JuanSegura98/LinearRegulator/doc/march-25.pptx

## Hito 1 Regulador Lineal

Diseño Avanzado de Sistemas Electrónicos


## Tabla de contenidos 01 03 04 02


Diagrama

Diseño

Diagrama de bloques del sistema

Diseño y validación por simulación de cada bloque

Resultados

BOM

Resultados experimentales

Lista de componentes y estado de adquisición

## Diagrama de bloques

Protección de sobrecorriente

Salida de voltaje

Regulador lineal

Lectura de corriente

Señal de referencia

FPGA

Señal de referencia

Lectura de tensión

Filtro paso-bajo

ICON] Square wave · Issue #165 · iconoir-icons/iconoir · GitHub

## Diseño – Global


## Diseño – Regulador


## Parámetros – Regulador

Parámetro | Valor | Justificación
R1 | 4k | Resistencia de protección Zener. Calculada para izmax = 3.5mA
R2 | 14k | Divisor de tensión resistivo. Calculado para multiplicar la señal de referencia x2.4 (2V -> 4.8V; 3.3V -> 7.94V)
R3 | 10k
Rload | 500 | Resistencia de prueba. Pruebas realizadas con rango de 100 a 1k
Vcc | 14 | Tensión del generador frente a tierra

## Simulación – Regulador


Notes: Barrido de Vout para distintas Vref

## Diseño – Protección de sobrecorriente


## Parámetros – Protección de sobrecorriente

Parámetro | Valor | Justificación
R4 | 6.2 | Calculada para i_rload_max = 150mA

## Simulación – Protección de sobrecorriente


Notes: Barrido de i_rload para distintas Rload

## Diseño – Lectura de corriente


## Parámetros – Lectura de corriente

Parámetro | Valor | Justificación
R6 | 3k | Amplificador de instrumentación ajustado para una ganancia de 4.5 (salida de 3.3V para 150mA de corriente con la resistencia de 6.2)
R7 | 5k
R8 | 5k
R9 | 5k
R10 | 5k
R11 | 5k
R12 | 5k

## Simulación – Lectura de corriente


Notes: Barrido de Vout para distintas Vref

## Diseño – Lectura de tensión


## Parámetros – Lectura de tensión

Parámetro | Valor | Justificación
| | Se usa seguidor de tensión porque la tensión a leer está en el rango 0-3.3V

## Simulación – Lectura de tensión


Notes: Barrido de Vout para distintas Vref

## Diseño – Filtro paso-bajo


## Parámetros – Filtro paso-bajo

Parámetro | Valor | Justificación
R13 | 1k | Filtro de 2º orden (por conexión de dos 1º orden) con frecuencia de corte de 160Hz
R14 | 1k
C1 | 1μ
C2 | 1μ

## Simulación – Filtro paso-bajo


Notes: Barrido de Vout para distintas Vref

## Simulación – Filtro paso-bajo

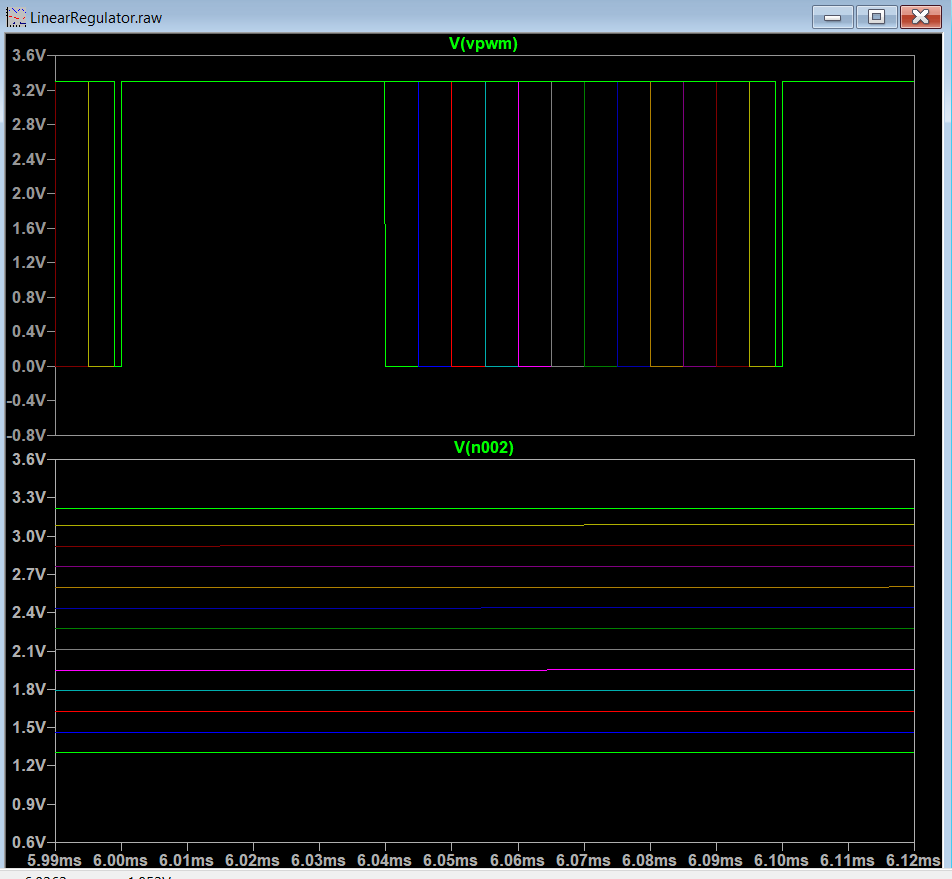
[picture p25: figure]

Notes: Barrido de Vout para distintas Vref

## Diseño – Global

## Simulación – Global


Notes: Barrido de Vout para distintas Vref

## BOM

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

## Estado del pedido

Componente | Cantidad | Precio unidad | Precio total | Estado | Notas
Resistencias | | | 0 | OK
Condensadores | | | 0 | OK
Protoboard | | | 0 | OK
Conectores Dupont | | | 0 | OK
BD135 | 2 | 0.665 | 1.33 | En carrito
BC547B | 2 | 0.361 | 0.722 | En carrito
LM741 | 10 | 0.76 | 7.6 | En carrito
OP07 | 6 | ----- | ----- | SIN EXISTENCIAS* | *Se sustituye por 6 LM741
Disipador TO126 | 1 | 5.64 | 5.64 | En carrito
TOTAL | | | 15.292
