JuanSegura98/LinearRegulator/doc/block-diagram.pptx

Overcurrent protection

Output

Current reader

Linear regulator

FPGA

Voltage reader

PWM
reference signal

DC
reference signal

Low-pass filter
