JuanSegura98/LinearRegulator/doc/BOM.xlsx

Sheet: BOM LTSpice
--- Bill of Materials ---
Ref. | Mfg. | Part No. | Description
C1 | -- | -- | capacitor, 1µF
C2 | -- | -- | capacitor, 1µF
Q1 | -- | BD135 | bipolar transistor
Q2 | NXP | BC547B | bipolar transistor
R1 | -- | -- | resistor, 4K
R2 | -- | -- | resistor, 14K
R3 | -- | -- | resistor, 10K
R4 | -- | -- | resistor, 6.2
R5 | -- | -- | resistor, 0
R6 | -- | -- | resistor, 3K
R7 | -- | -- | resistor, 5K
R8 | -- | -- | resistor, 5K
R9 | -- | -- | resistor, 5K
R10 | -- | -- | resistor, 5K
R11 | -- | -- | resistor, 5K
R12 | -- | -- | resistor, 5K
R13 | -- | -- | resistor, 1K
R14 | -- | -- | resistor, 1K
Uopamp_linearRegulator | (unknown) | LM741 | (unknown 3rd party model)
Uopamp_linearRegulator1 | (unknown) | LM741 | (unknown 3rd party model)
Uopamp_linearRegulator2 | (unknown) | LM741 | (unknown 3rd party model)
Uopamp_linearRegulator3 | (unknown) | LM741 | (unknown 3rd party model)
Uopamp_linearRegulator4 | (unknown) | LM741 | (unknown 3rd party model)
Uopamp_linearRegulator5 | (unknown) | LM741 | (unknown 3rd party model)
Uopamp_linearRegulator6 | (unknown) | LM741 | (unknown 3rd party model)
TO126 Heatsink | -- | TO126 Heatsink | TO126 Heatsink
TO222 Heatsink* | -- | TO222 Heatsink* | TO222 Heatsink*

Sheet: Pedido
Count of Ref. | Column Labels
Row Labels | (unknown 3rd party model) | bipolar transistor | capacitor, 1µF | resistor, 0 | resistor, 10K | resistor, 14K | resistor, 1K | resistor, 3K | resistor, 4K | resistor, 5K | resistor, 6.2 | TO126 Heatsink | TO222 Heatsink* | Grand Total
-- |  |  | 2 | 1 | 1 | 1 | 2 | 1 | 1 | 6 | 1 |  |  | 16
BC547B |  | 1 |  |  |  |  |  |  |  |  |  |  |  | 1
LM741 | 7 |  |  |  |  |  |  |  |  |  |  |  |  | 7
TO126 Heatsink |  |  |  |  |  |  |  |  |  |  |  | 1 |  | 1
BD135 |  | 1 |  |  |  |  |  |  |  |  |  |  |  | 1
TO222 Heatsink* |  |  |  |  |  |  |  |  |  |  |  |  | 1 | 1
Grand Total | 7 | 2 | 2 | 1 | 1 | 1 | 2 | 1 | 1 | 6 | 1 | 1 | 1 | 27
Componente | Cantidad | Reserva | Cantidad + Reserva | Precio Unitario | Precio Total | Obtenido | Notas
Condensador | 2 | 98 | 100 |  |  | 5 | Compramos varios
Resistencia | 13 | 87 | 100 |  |  | 0 | Compramos varios
BC547B | 1 | 1 | 2 | 0.361 | 0.722 | 2
LM741 | 7 | 3 | 10 | 0.542 | 5.42 | 10 | OpAmps
TO126 Heatsink | 1 | 0 | 1 | 5.64 | 5.64 | 1 | Disipador transistor laboratorio
BD135 | 1 | 1 | 2 | 1.05 | 2.1 | 2 | Transistor de potencia*
TO222 Heatsink* | 1 | 0 | 1 | 0.9 | 0.9 | 1 | Disipador transistor de potencia
TOTAL | 14.782
ENVÍO | 20
TOTAL+ENVÍO | 34.782
