JuanSegura98/LinearRegulator/LinearRegulator.asc

C1: cap; 1µ
C2: cap; 1µ
Q1: npn; BD135
Q2: npn; BC547B
R1: res; 4k
R2: res; 14k
R3: res; 10k
R4: res; 6.2
R5: res; {Rload}
R6: res; 3k
R7: res; 5k
R8: res; 5k
R9: res; 5k
R10: res; 5k
R11: res; 5k
R12: res; 5k
R13: res; 1k
R14: res; 1k
Uopamp_linearRegulator1: LM741
Uopamp_linearRegulator2: LM741
Uopamp_linearRegulator3: LM741
Uopamp_linearRegulator4: LM741
Uopamp_linearRegulator5: LM741
Uopamp_linearRegulator6: LM741
Uopamp_linearRegulator: LM741
Vcc_generator: voltage; 14
Vfpga: voltage; PULSE(0 {FPGAvcc} 0 {FPGAtrise} {FPGAtfall} {1/FPGAfreq * FPGApwm} {1/FPGAfreq} 1000)
Vref_generator: voltage; {Vref}
Named nets: 0, Vcc+, Vcurrent+, Vcurrent-, Vcurrent, CAD, Vref, Vo
.tran 15m
;step param Rload 1 500 20
.op
.model BD135 NPN(Is=40f Xti=3 Eg=1.11 Vaf=115.7 Bf=180.2 Ise=40f Ne=1.363 Ikf=4.927 Nk=1.247 Xtb=1.5 Br=10 Isc=85f Nc=2 Ikr=0 Rc=0 Cjc=19.23p Mjc=.3439 Vjc=.5635 Fc=.5 Cje=60.49p Mje=.3589 Vje=.7585 Tr=116n Tf=550p Itf=1 Xtf=0 Vtf=10 QCO=1E-10 GAMMA=1E-8 RCO=5)
;param Rload=500 FPGApwm=0.9
.model BC547B NPN(IS=2.39E-14 NF=1.008 ISE=3.545E-15 NE=1.541 BF=294.3 IKF=0.1357 VAF=63.2 NR=1.004 ISC=6.272E-14 NC=1.243 BR=7.946 IKR=0.1144 VAR=25.9 RB=1 IRB=1.00E-06 RBM=1 RE=0.4683 RC=0.85 XTB=0 EG=1.11 XTI=3 CJE=1.358E-11 VJE=0.65 MJE=0.3279 TF=4.391E-10 XTF=120 VTF=2.643 ITF=0.7495 PTF=0 CJC=3.728E-12 VJC=0.3997 MJC=0.2955 XCJC=0.6193 TR=1.00E-32 CJS=0 VJS=0.75 MJS=0.333 FC=0.9579 Vceo=45 Icrating=100m mfg=Philips)
;step param Vref 2 3.3 0.2
.param FPGAfreq=10k FPGAvcc=3.3 FPGAtrise=1n FPGAtfall=1n Vref=2
.param Rload=500
;step param FPGApwm 0.4 0.99 0.05
.param FPGApwm=0.99
