JuanSegura98/LinearRegulator/Filter.asc

C3: cap; 100n
C4: cap; 100n
R5: res; 1k
R6: res; 1k
U2: OP07
U3: OP07
V1: voltage; 7
V3: voltage; PULSE(0 6.6 0 1n 1n 990n 1u 10000)
Named nets: 0, Vcc, Vin, Vout
.tran 500u
