JuanSegura98/LinearRegulator/(commit log)

2025-03-12 Instrumentation amplifier to measure voltage drop in overcurrent resistor (proportional to current being drowned). Error fixes
2025-03-17 Added pdf with specifications of the final circuit
2025-03-17 Added voltage sensor and updated components and resistor values to specification. TODO: adjust the voltage sensor to 0-3.3V (miscalculation).
2025-03-17 Adjusted resistors for the current and voltage sensors. Adjusted overcurrent resistor. Added variable reference voltage. TODO: see if reference must go from 0 to 3.3V (currently 2.0-3.3V for an outpu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
2025-03-23 Added FPGA and low-pass filter
2025-03-23 Added BOM to ppt 1
2025-03-27 Added BOM
    [BOM.xlsx]
2025-03-27 Updated BOM with received items
    [BOM.xlsx]
